jiantleman/embedded-systems-timer/timer/timer_tests.ino

/*
 * A struct to keep all state inputs in one place
 */
typedef struct {
  volatile int button_array[4];
  volatile int steps_taken;
} state_inputs;

/*
 * A struct to keep all state variables in one place
 */
typedef struct {
  int timer;
  int freq_step;
} state_vars;

extern int mocked_timer;
extern float mocked_freq_step;

bool test_transition(state start_state,
                     state end_state,
                     state_inputs test_state_inputs, 
                     state_vars start_state_vars,
                     state_vars end_state_vars,
                     int output_fn,
                     bool verbos);

/*        
 * Helper function for printing states
 */
char* s2str(state s) {
  switch(s) {
    case sSTARTING:
    return "(1) STARTING";
    case sRUNNING:
    return "(2) RUNNING";
    case sPAUSED:
    return "(3) PAUSED";
    case sFINISHED:
    return "(4) FINISHED";
    default:
    return "???";
  }
}

/*
 * Given a start state, inputs, and starting values for state variables, tests that
 * update_fsm returns the correct end state and updates the state variables correctly
 * returns true if this is the case (test passed) and false otherwise (test failed)
 * 
 * Need to use "verbos" instead of "verbose" because verbose is apparently a keyword
 */
bool test_transition(state start_state,
                     state end_state,
                     state_inputs test_state_inputs,
                     state_vars start_state_vars,
                     state_vars end_state_vars,
                     int output_fn,
                     bool verbos) {
  timer = start_state_vars.timer;
  freq_step = start_state_vars.freq_step;

  state result_state = update_fsm(start_state, test_state_inputs.button_array, test_state_inputs.steps_taken);

  bool passed_test = (end_state == result_state and
                      timer == end_state_vars.timer and
                      freq_step == end_state_vars.freq_step);
  bool passed_output_fn = true;
  if (output_fn == 1) { // set_lights
    passed_output_fn = (mocked_timer == end_state_vars.timer);
  } else if (output_fn == 2) {
    passed_output_fn = (mocked_freq_step == end_state_vars.freq_step);
  }

  if (! verbos) {
    return passed_test and passed_output_fn;
  } else if (passed_test and passed_output_fn) {
    char s_to_print[200];
    sprintf(s_to_print, "Test from %s to %s PASSED", s2str(start_state), s2str(end_state));
    Serial.println(s_to_print);
    return true;
  } else {
    char s_to_print[200];
    Serial.println(s2str(start_state));
    sprintf(s_to_print, "Test from %s to %s FAILED", s2str(start_state), s2str(end_state));
    Serial.println(s_to_print);
    sprintf(s_to_print, "End state expected: %s | actual: %s", s2str(end_state), s2str(result_state));
    Serial.println(s_to_print);
    return false;
  }
}

/*
 * REPLACE THE FOLLOWING 6 LINES WITH YOUR TEST CASES
 */
const state test_states_in[14] =     {(state) 1    , (state) 1    , (state) 1    , (state) 1    , (state) 1    , (state) 1    , (state) 2     , (state) 2       , (state) 2     , (state) 3     , (state) 3     , (state) 3     , (state) 4       , (state) 4     };
const state test_states_out[14] =    {(state) 1    , (state) 1    , (state) 1    , (state) 1    , (state) 1    , (state) 2    , (state) 3     , (state) 4       , (state) 2     , (state) 1     , (state) 2     , (state) 3     , (state) 1       , (state) 4     };
const state_inputs test_input[14] =  {{{0,0,1,0},0}, {{0,0,0,1},0}, {{0,0,1,0},0}, {{0,0,0,1},0}, {{0,0,1,1},0}, {{1,0,0,0},0}, {{1,0,0,0},40}, {{0,0,0,0},2400}, {{0,0,0,0},40}, {{0,1,0,0},40}, {{1,0,0,0},40}, {{0,0,0,0},40}, {{0,1,0,0},2400}, {{0,0,0,0},40}};
const state_vars test_in_vars[14] =  {{2, 20}      , {2, 20}      , {4, 10}      , {1, 40}      , {2, 20}      , {3, 13.33333}, {4, 10}       , {2, 20}         , {2, 20}       , {1, 40}       , {3, 13.333333}, {3, 13.333333}, {4, 10}         , {4, 10}};
const state_vars test_out_vars[14] = {{3, 13.33333}, {1, 40}      , {4, 10}      , {1, 40}      , {2, 20}      , {3, 13.33333}, {4, 10}       , {2, 20}         , {2, 20}       , {1, 40}       , {3, 13.333333}, {3, 13.333333}, {4, 10}         , {4, 10}};
const int test_output_fns[14] =      {1            , 1            , 0            , 0            , 0            , 2            , 3             , 3               , 0             , 4             , 2             , 0             , 4               , 0};
const int num_tests = 14;

/*
 * Runs through all the test cases defined above
 */
bool test_fsm() {
  for (int i = 0; i < num_tests; i++) {
    Serial.print("Running test ");
    Serial.println(i);
    if (!test_transition(test_states_in[i], test_states_out[i], test_input[i], test_in_vars[i], test_out_vars[i], test_output_fns[i], true)) {
      return false;
    }
    Serial.println();
  }
  Serial.println("All FSM Tests Passed!");
  return true;
}

bool test_button_handlers() {
  Serial.println("Click Start/Pause Button");
  while(button_array[START_PAUSE_BUTTON] != 1);
  clear_buttons();
  Serial.println("Click Reset Button");
  while(button_array[RESET_BUTTON] != 1);
  clear_buttons();
  Serial.println("Click Increment Button");
  while(button_array[INC_BUTTON] != 1);
  clear_buttons();
  Serial.println("Click Decrement Button");
  while(button_array[DEC_BUTTON] != 1);
  Serial.println("Button Handlers Works!");
  return true;
}

bool test_leds() {
  Serial.println("Timer = 1");
  set_lights(1);
  delay(2000);
  Serial.println("Timer = 2");
  set_lights(2);
  delay(2000);
  Serial.println("Timer = 3");
  set_lights(3);
  delay(2000);
  Serial.println("Timer = 4");
  set_lights(4);
  delay(2000);
  return true;
}

bool test_stepper() {
  stepper.runToNewPosition(0);
  stepper.runToNewPosition(500);
  stepper.runToNewPosition(100);
  stepper.runToNewPosition(120);
  return true;
}
