jiantleman/embedded-systems-timer/(commit log)

2021-10-29 Button interrupts, set_lights done
2021-11-04 Prevent Interrupts During Updates
    [timer.ino]
2021-11-19 Updated FSM for mutual exclusion, added stepper and TC control
2021-11-26 Stepper Motor Reverse Added
    [timer.h, timer_utils.ino]
2021-12-01 Better Serial Monitor Prints
2021-12-03 Trying to Fix Timer
    [timer.h, timer.ino, timer_utils.ino]
2021-12-07 Fixed Timer Issue
